TADE23/Gate-controller-based-on-ATmega8/README.md

# Gate-controller-based-on-ATmega8
Це проект контролера для відкатних або розпашних воріт.
Більше інформації про проект знаходить в файлі KPI_GATE.docx а також коротке відео із демонстрацією роботи можна переглянути на YouTube за посиланням: https://youtu.be/KMa-NpUTwA8
